jeonwonje/beachboys/docs/figures/fig17-b40-rates.png

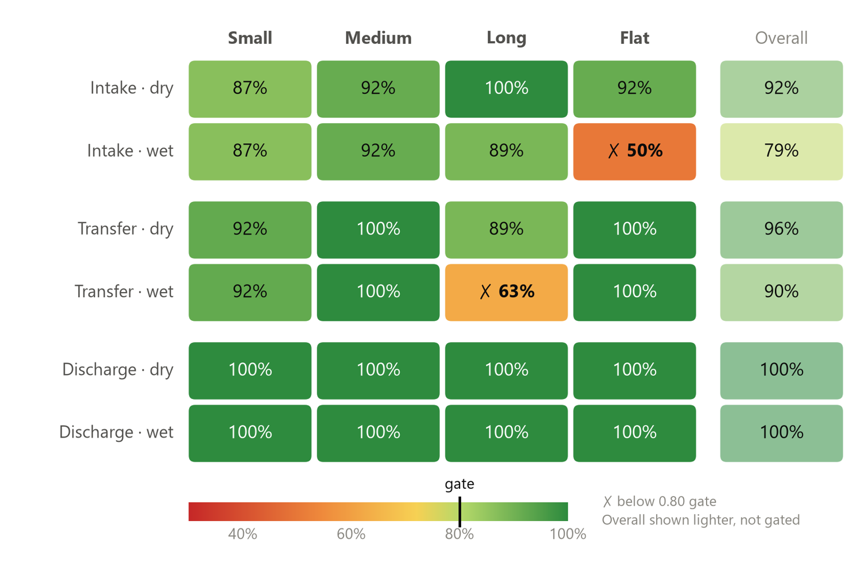
docs/figures/fig17-b40-rates.png
