jeonwonje/beachboys/docs/figures/fig25-settling.jpg

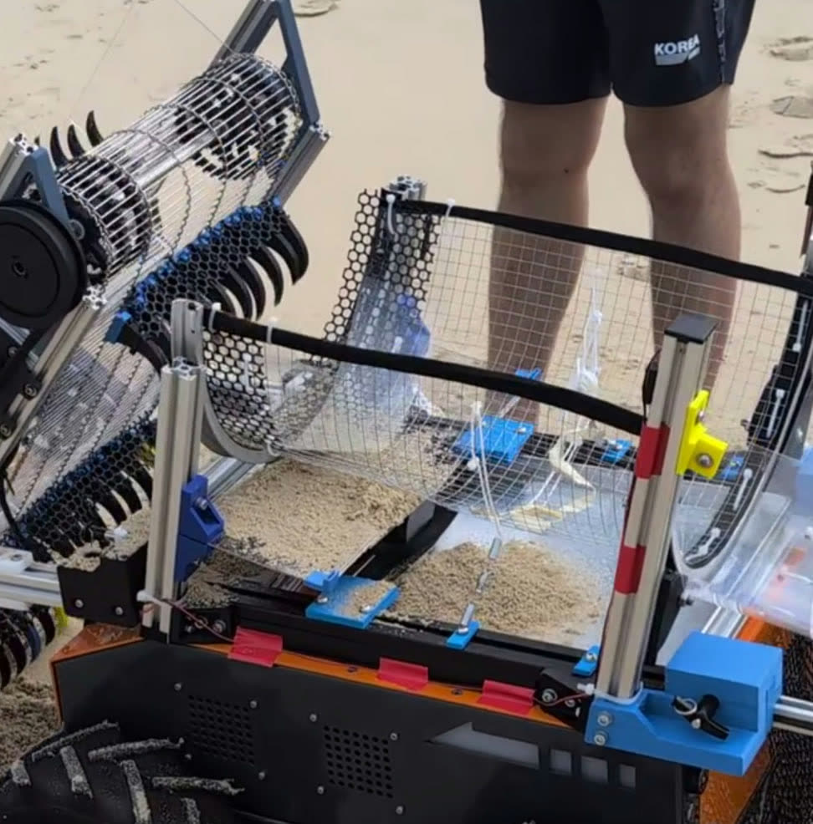
docs/figures/fig25-settling.jpg
