jeonwonje/beachboys/hardware/module/ASI-301_integrated_assembly.step

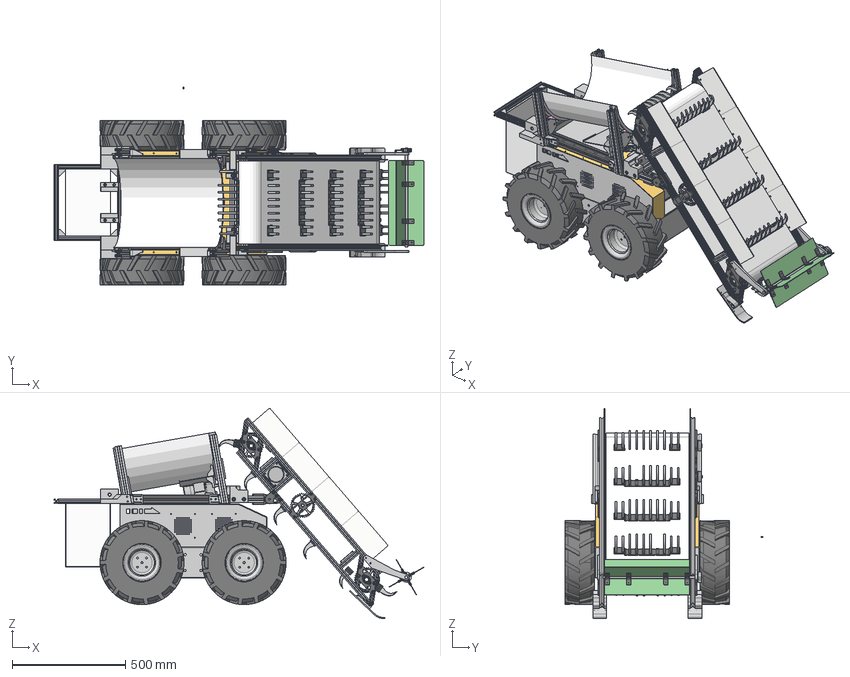
[picture p9: CAD file, 2026-11-07]
hardware/module/ASI-301_integrated_assembly.step
1630.1 x 873.8 x 925.6 mm
sheet metal cover
upper compartment
bottom compartment
shaft bearing
wheel hub
wheel axle
wheel
shaft bearing v1(Mirror)
wheel hub v1(Mirror)
wheel axle v1(Mirror)
wheel v1(Mirror)
shaft bearing v1(Mirror) (1)
wheel hub v1(Mirror) (1)
wheel axle v1(Mirror) (1)
wheel v1(Mirror) (1)
shaft bearing v1(Mirror)(Mirror)
wheel hub v1(Mirror)(Mirror)
wheel axle v1(Mirror)(Mirror)
wheel v1(Mirror)(Mirror)
2020 Extrusion 336mm x 2
2020 bracket x 4
collection bin mesh
2020 Extrusion 260mm x 2
sand collection plate
back pin mount on bin x 2
back pin mount on 4040
back pin mount on 4040 v17(Mirror)
2020 Frame long x 2
2020 Frame wide x 4
2020 Motor mount x 3
2020 Frame horizontal support x 2
2020 90° plate x 2
2020 90° connector x 4
Skid
Skid inner mount
Skid outer mount
20x23x21.5mm GFM Plain bearing
P30S5M0100AAL-NA-P-20_p
SET-SCREW6-8
SET-SCREW6-8_1
20mm OD Drive axle
9.2mm Pitch sproket (2)
9.2mm Pitch sproket (1)
9.2mm Pitch sproket (2)_1
9.2mm Pitch sproket (1)_1
20mm OD Idler axle
20x23x21.5mm GFM Plain bearing_1
Bearing retainer
P30S5M0100AAL-NA-N-10_p
SET-SCREW4-3
SET-SCREW4-3_1
GPG24V 40W 80mm Motor
Drive shaft mount
Motor mount
Drive shaft mount_1
Conveyor square panel x 4
middle support bearing
12.7x100mm OD unit axle v1
9.2mm Pitch sproket (2)_2
9.2mm Pitch sproket (1)_2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
