jeonwonje/beachboys/hardware/electronics-case/Case_v3_Wall_Front.SLDPRT

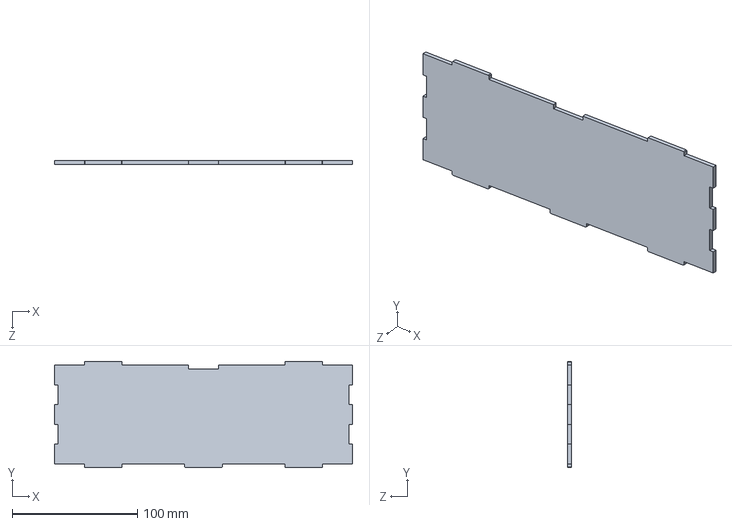
[picture p10: CAD file, 2026-11-06]
hardware/electronics-case/Case_v3_Wall_Front.SLDPRT
237.8 x 84.8 x 2.90 mm
