jeonwonje/beachboys/hardware/electronics-case/ASI301_case_acrylic_3mm_nest_revB.dxf

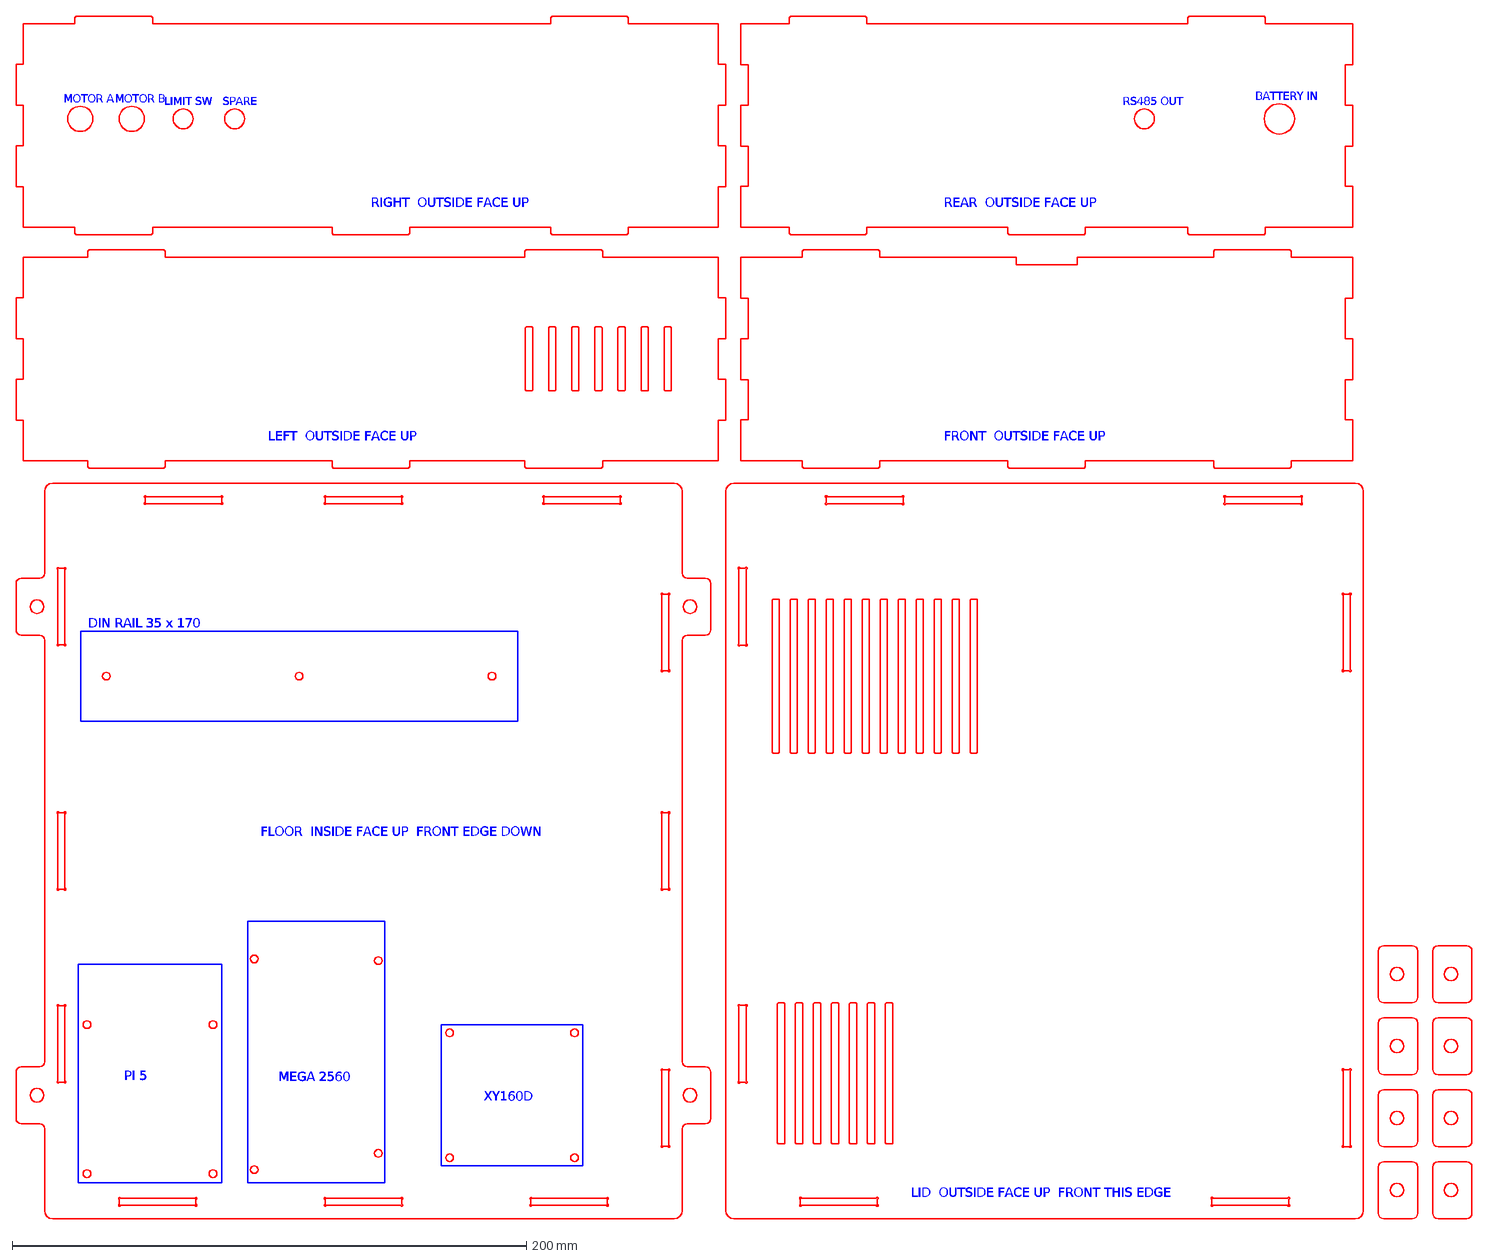
[picture p11: CAD file, 2026-11-06]
hardware/electronics-case/ASI301_case_acrylic_3mm_nest_revB.dxf
PI 5
MEGA 2560
XY160D
DIN RAIL 35 x 170
FLOOR INSIDE FACE UP FRONT EDGE DOWN
LID OUTSIDE FACE UP FRONT THIS EDGE
LEFT OUTSIDE FACE UP
FRONT OUTSIDE FACE UP
MOTOR A
MOTOR B
LIMIT SW
SPARE
RIGHT OUTSIDE FACE UP
BATTERY IN
RS485 OUT
REAR OUTSIDE FACE UP
