jeonwonje/beachboys/hardware/electronics-case/Case_v3_Floor.SLDPRT

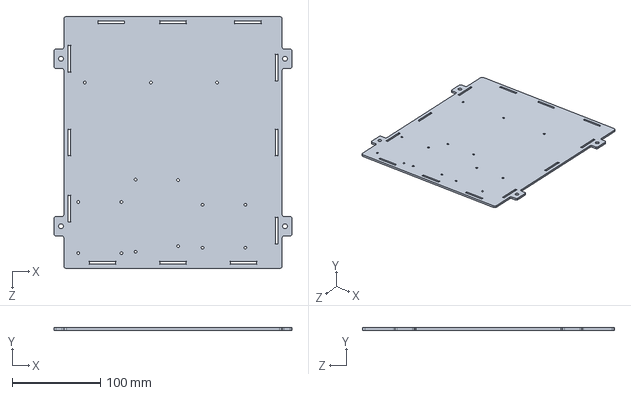
[picture p12: CAD file, 2026-11-06]
hardware/electronics-case/Case_v3_Floor.SLDPRT
270.0 x 2.90 x 285.8 mm
