jeonwonje/beachboys/hardware/electronics-case/Case_v3_Wall_Left.SLDPRT

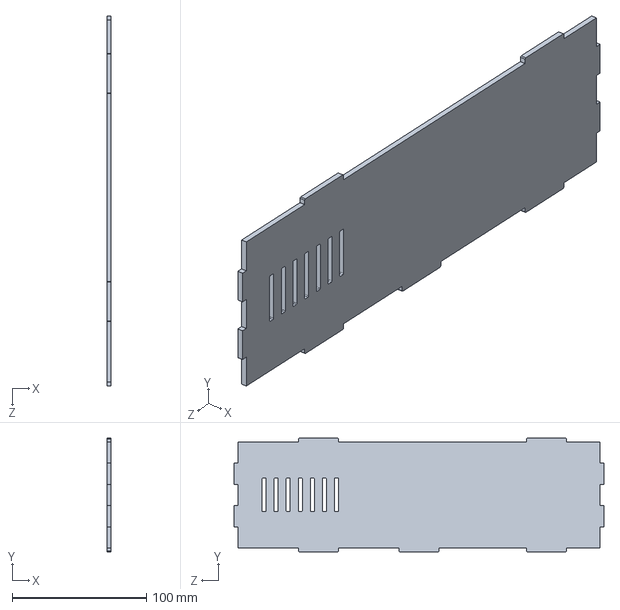
[picture p13: CAD file, 2026-11-06]
hardware/electronics-case/Case_v3_Wall_Left.SLDPRT
2.90 x 84.8 x 275.8 mm
