jeonwonje/beachboys/hardware/electronics-case/M3 brass standoff Mega post.SLDPRT

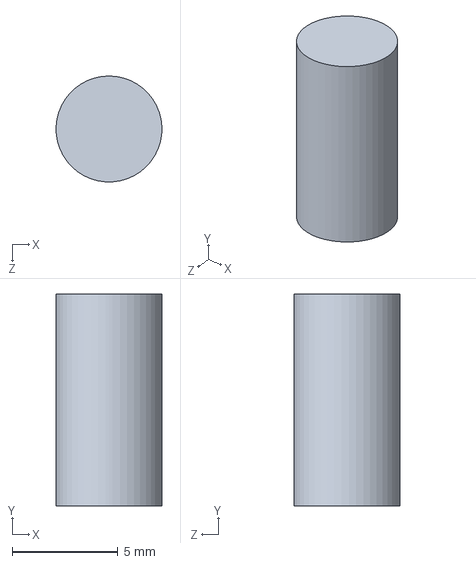
[picture p14: CAD file, 2026-11-06]
hardware/electronics-case/M3 brass standoff Mega post.SLDPRT
5.00 x 10.0 x 5.00 mm
