jeonwonje/beachboys/hardware/electronics-case/ASI301_fit_coupon_3mm.dxf

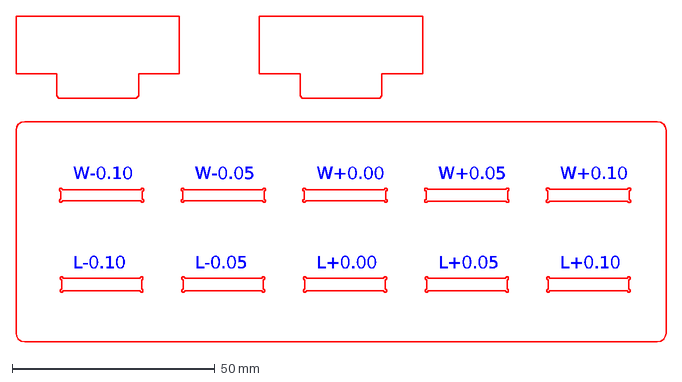
[picture p15: CAD file, 2026-11-06]
hardware/electronics-case/ASI301_fit_coupon_3mm.dxf
W-0.10
L-0.10
W-0.05
L-0.05
W+0.00
L+0.00
W+0.05
L+0.05
W+0.10
L+0.10
