jeonwonje/beachboys/hardware/electronics-case/Case_v3_Pads.SLDPRT

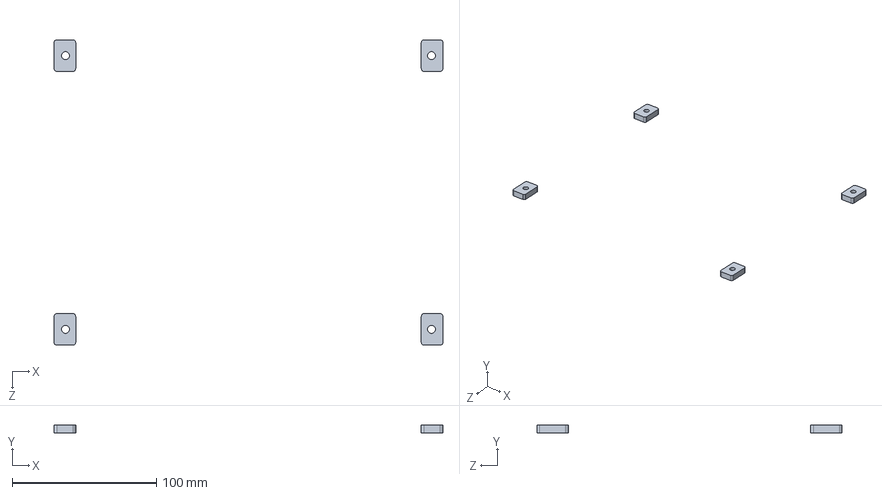
[picture p16: CAD file, 2026-11-06]
hardware/electronics-case/Case_v3_Pads.SLDPRT
270.0 x 5.80 x 212.0 mm
