jeonwonje/beachboys/hardware/electronics-case/Case_v3_Lid.SLDPRT

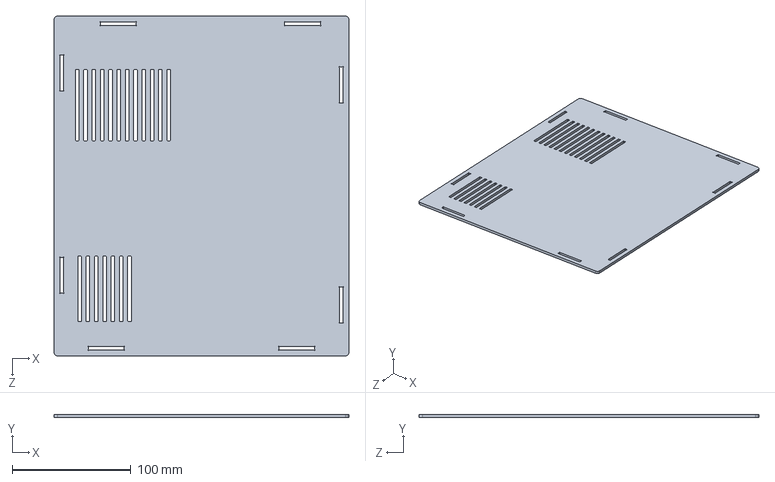
[picture p17: CAD file, 2026-11-06]
hardware/electronics-case/Case_v3_Lid.SLDPRT
247.8 x 2.90 x 285.8 mm
