jeonwonje/beachboys/hardware/electronics-case/ASI-301 Electronics Case v3.step

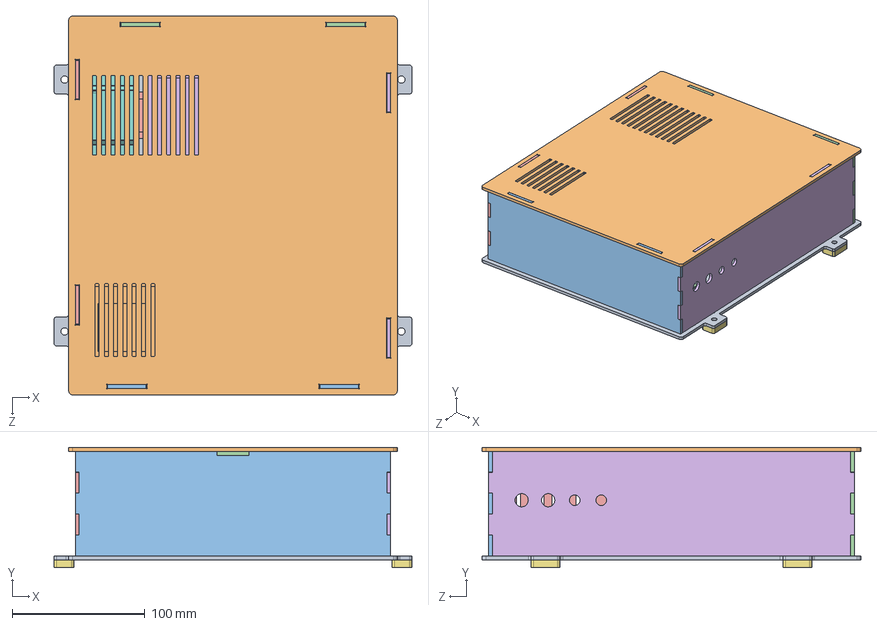
[picture p18: CAD file, 2026-11-06]
hardware/electronics-case/ASI-301 Electronics Case v3.step
270.0 x 90.6 x 285.8 mm
Case_v3_Floor
Case_v3_Lid
Case_v3_Wall_Front
Case_v3_Wall_Rear
Case_v3_Wall_Left
Case_v3_Wall_Right
Case_v3_Pads
M3 brass standoff Mega post
M3 brass standoffs x11
Raspberry Pi 5 (block)
Arduino Mega 2560
XY160D motor driver
DIN rail 35x7.5 170mm
Waveshare USB TO 2CH RS485
Relay module 5V 30A DIN
DDR-30G-5
