jeonwonje/beachboys/(list of files, cad)

Other CAD files:
hardware/electronics-case/Case_v3_Wall_Right.SLDPRT
hardware/electronics-case/Case_v3_Wall_Rear.SLDPRT
hardware/electronics-case/ASI-301 Electronics Case v3.SLDASM
