jeonwonje/beachboys/hardware/electrical/XY160D_Mega2560_wiring.png

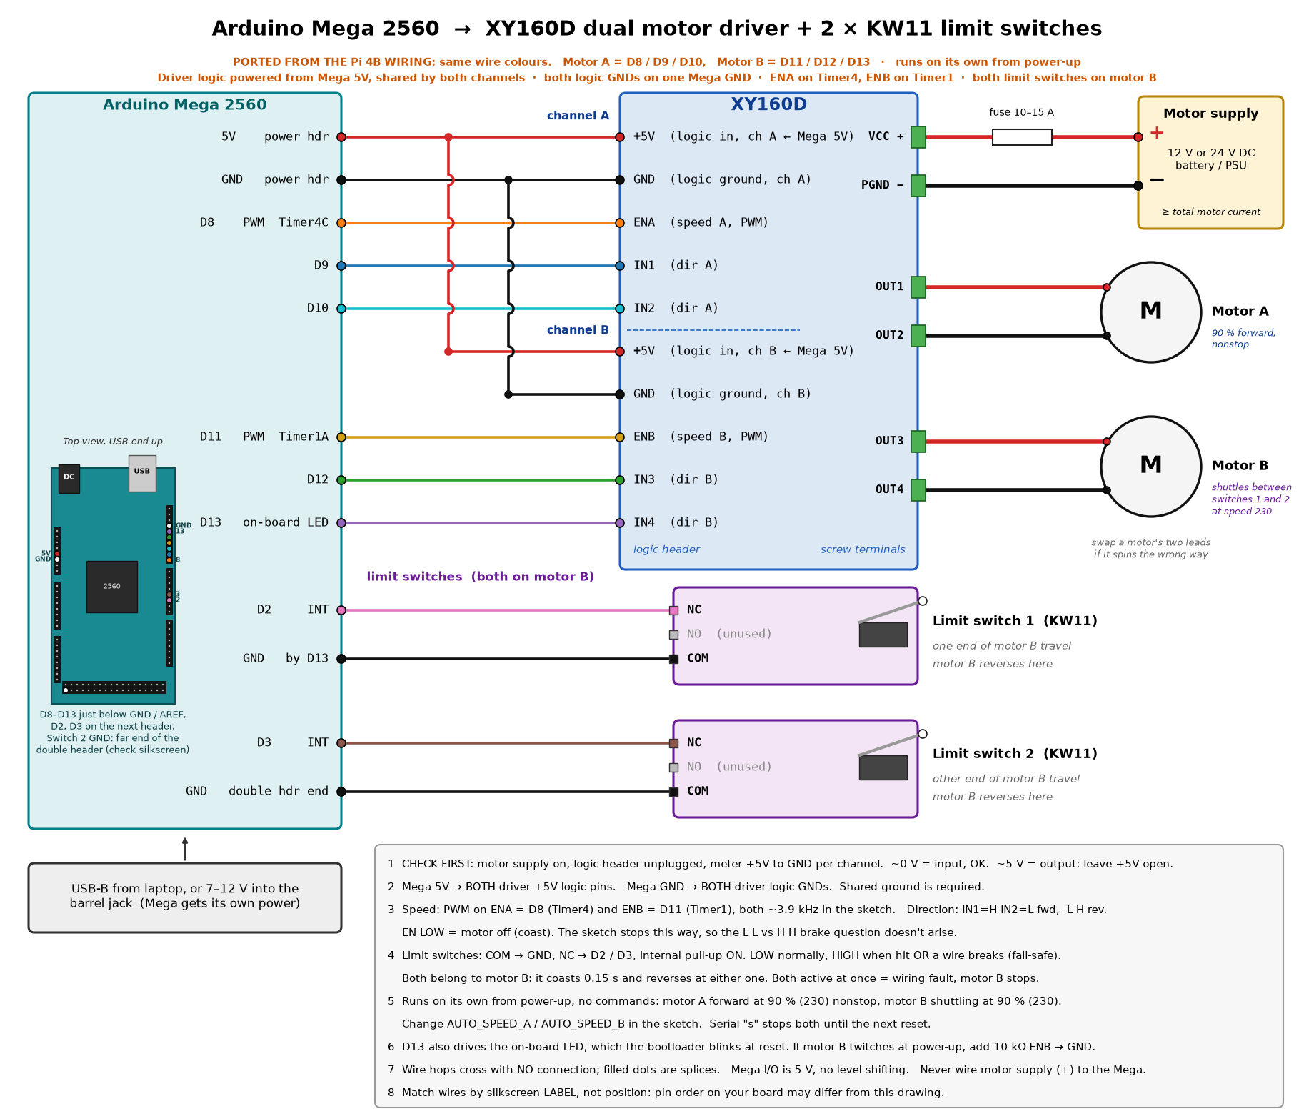
hardware/electrical/XY160D_Mega2560_wiring.png
