jeonwonje/beachboys/hardware/electronics-case/ASI301_case_acrylic_3mm_revB.pdf

## LID

## REAR

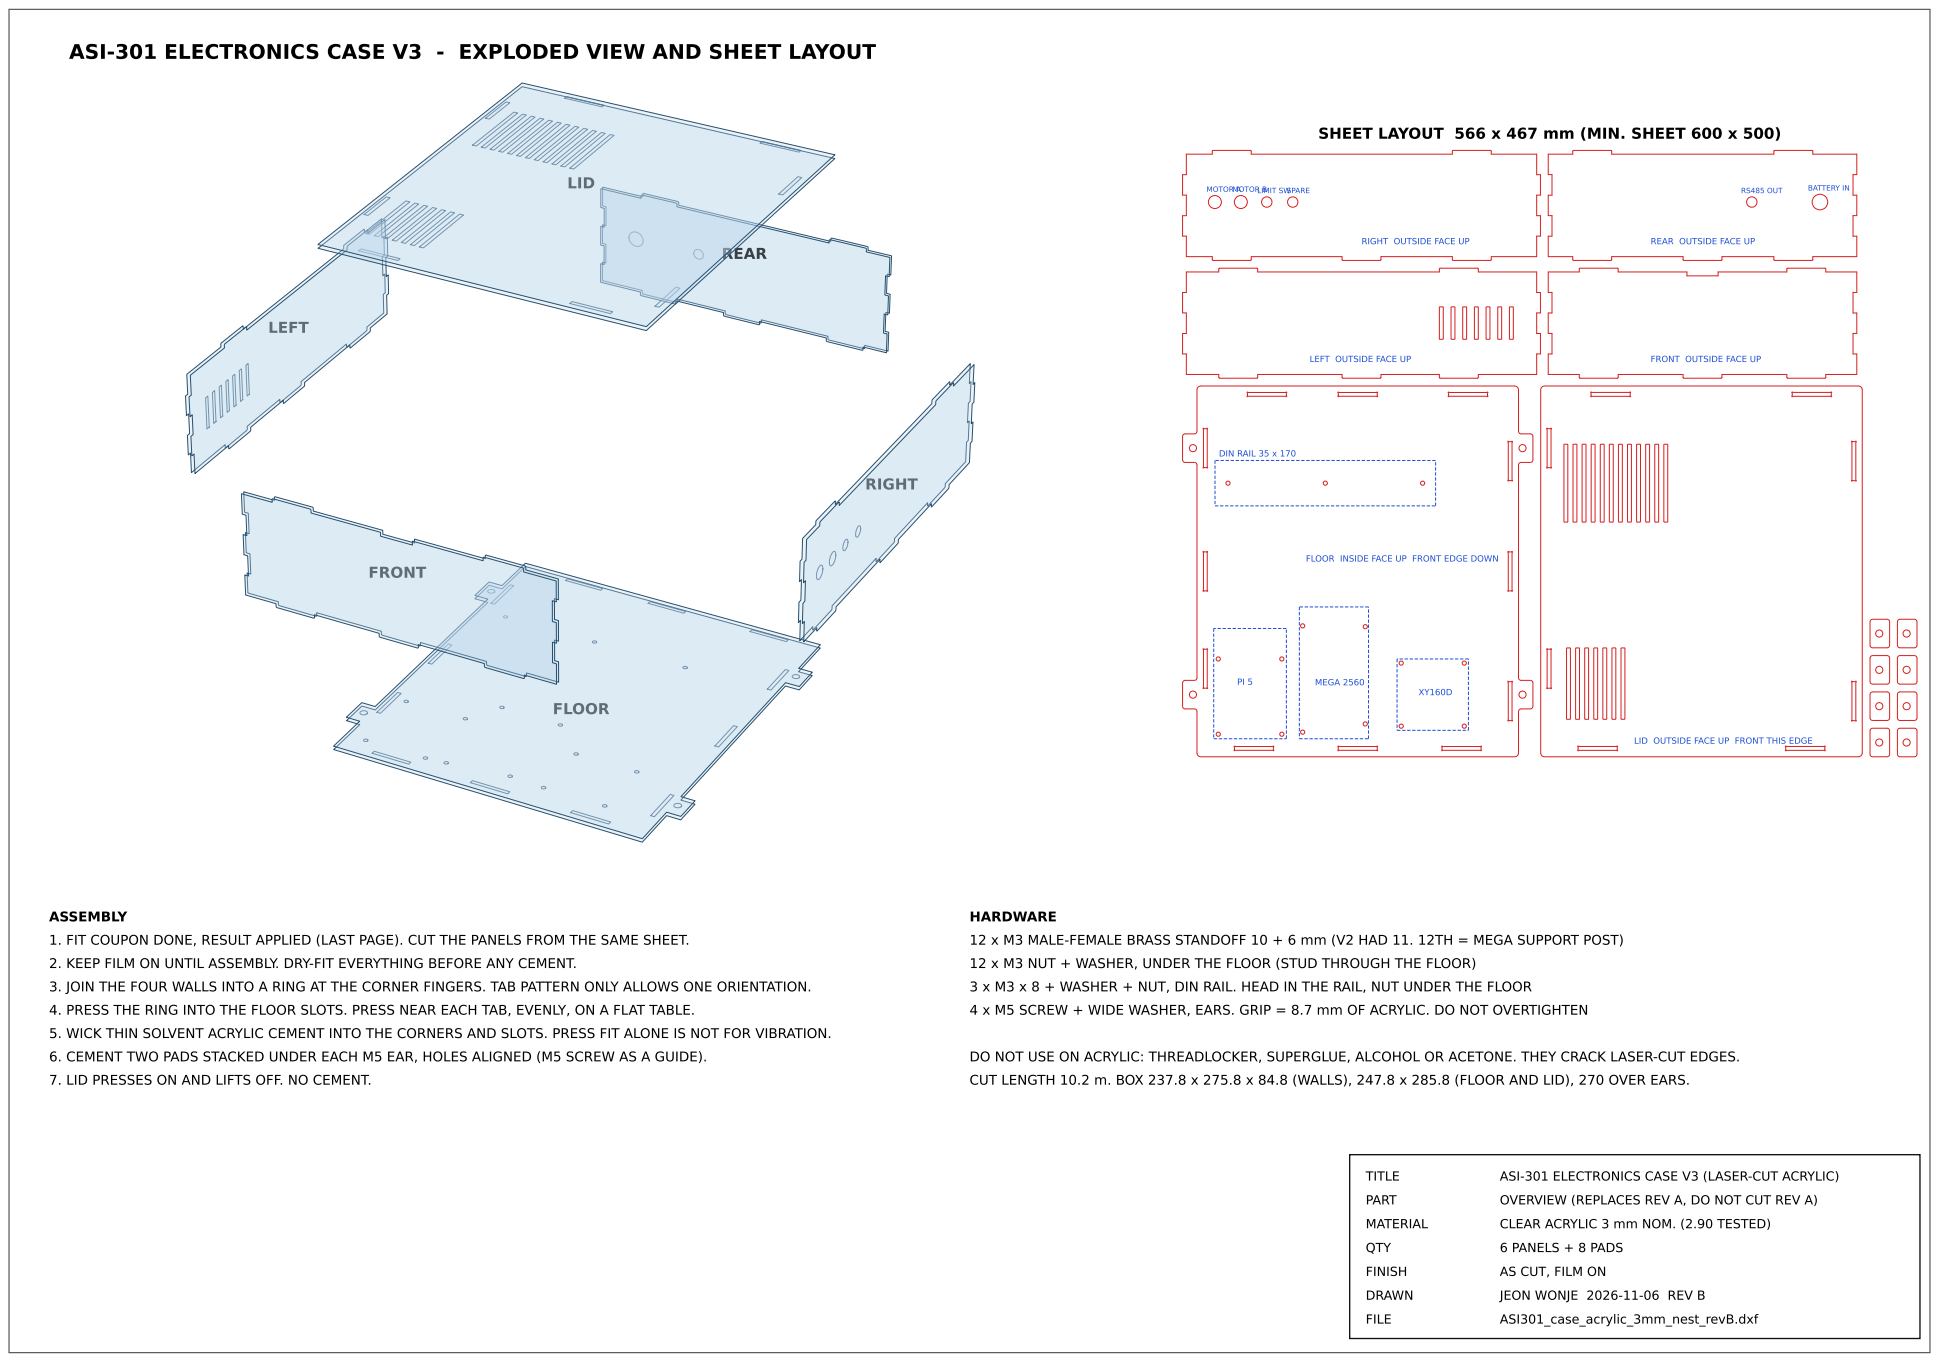
[picture p22: page 1]
FLOOR; FRONT; LEFT; RIGHT; MEGA 2560; DIN RAIL 35 x 170; LEFT OUTSIDE FACE UP; FRONT OUTSIDE FACE UP; RS485 OUT; BATTERY IN; TITLE; ASI-301 ELECTRONICS CASE V3 (LASER-CUT ACRYLIC); PART; OVERVIEW (REPLACES REV A, DO NOT CUT REV A); MATERIAL; CLEAR ACRYLIC 3 mm NOM. (2.90 TESTED); QTY; 6 PANELS + 8 PADS; FINISH; AS CUT, FILM ON; DRAWN; JEON WONJE 2026-11-06 REV B; FILE; ASI301_case_acrylic_3mm_nest_revB.dxf

ASI-301 ELECTRONICS CASE V3 - EXPLODED VIEW AND SHEET LAYOUT

SHEET LAYOUT 566 x 467 mm (MIN. SHEET 600 x 500)

MOTOR AMOTOR BLIMIT SWSPARE

RIGHT OUTSIDE FACE UP

REAR OUTSIDE FACE UP

FLOOR INSIDE FACE UP FRONT EDGE DOWN

LID OUTSIDE FACE UP FRONT THIS EDGE

ASSEMBLY
1. FIT COUPON DONE, RESULT APPLIED (LAST PAGE). CUT THE PANELS FROM THE SAME SHEET.
2. KEEP FILM ON UNTIL ASSEMBLY. DRY-FIT EVERYTHING BEFORE ANY CEMENT.
3. JOIN THE FOUR WALLS INTO A RING AT THE CORNER FINGERS. TAB PATTERN ONLY ALLOWS ONE ORIENTATION.
4. PRESS THE RING INTO THE FLOOR SLOTS. PRESS NEAR EACH TAB, EVENLY, ON A FLAT TABLE.
5. WICK THIN SOLVENT ACRYLIC CEMENT INTO THE CORNERS AND SLOTS. PRESS FIT ALONE IS NOT FOR VIBRATION.
6. CEMENT TWO PADS STACKED UNDER EACH M5 EAR, HOLES ALIGNED (M5 SCREW AS A GUIDE).
7. LID PRESSES ON AND LIFTS OFF. NO CEMENT.

HARDWARE
12 x M3 MALE-FEMALE BRASS STANDOFF 10 + 6 mm (V2 HAD 11. 12TH = MEGA SUPPORT POST)
12 x M3 NUT + WASHER, UNDER THE FLOOR (STUD THROUGH THE FLOOR)
3 x M3 x 8 + WASHER + NUT, DIN RAIL. HEAD IN THE RAIL, NUT UNDER THE FLOOR
4 x M5 SCREW + WIDE WASHER, EARS. GRIP = 8.7 mm OF ACRYLIC. DO NOT OVERTIGHTEN

DO NOT USE ON ACRYLIC: THREADLOCKER, SUPERGLUE, ALCOHOL OR ACETONE. THEY CRACK LASER-CUT EDGES.
CUT LENGTH 10.2 m. BOX 237.8 x 275.8 x 84.8 (WALLS), 247.8 x 285.8 (FLOOR AND LID), 270 OVER EARS.

FLOOR (INSIDE FACE UP) - NTS - DATUM 0,0 BOTTOM-LEFT | TAG | X | Y SIZE | FEATURE

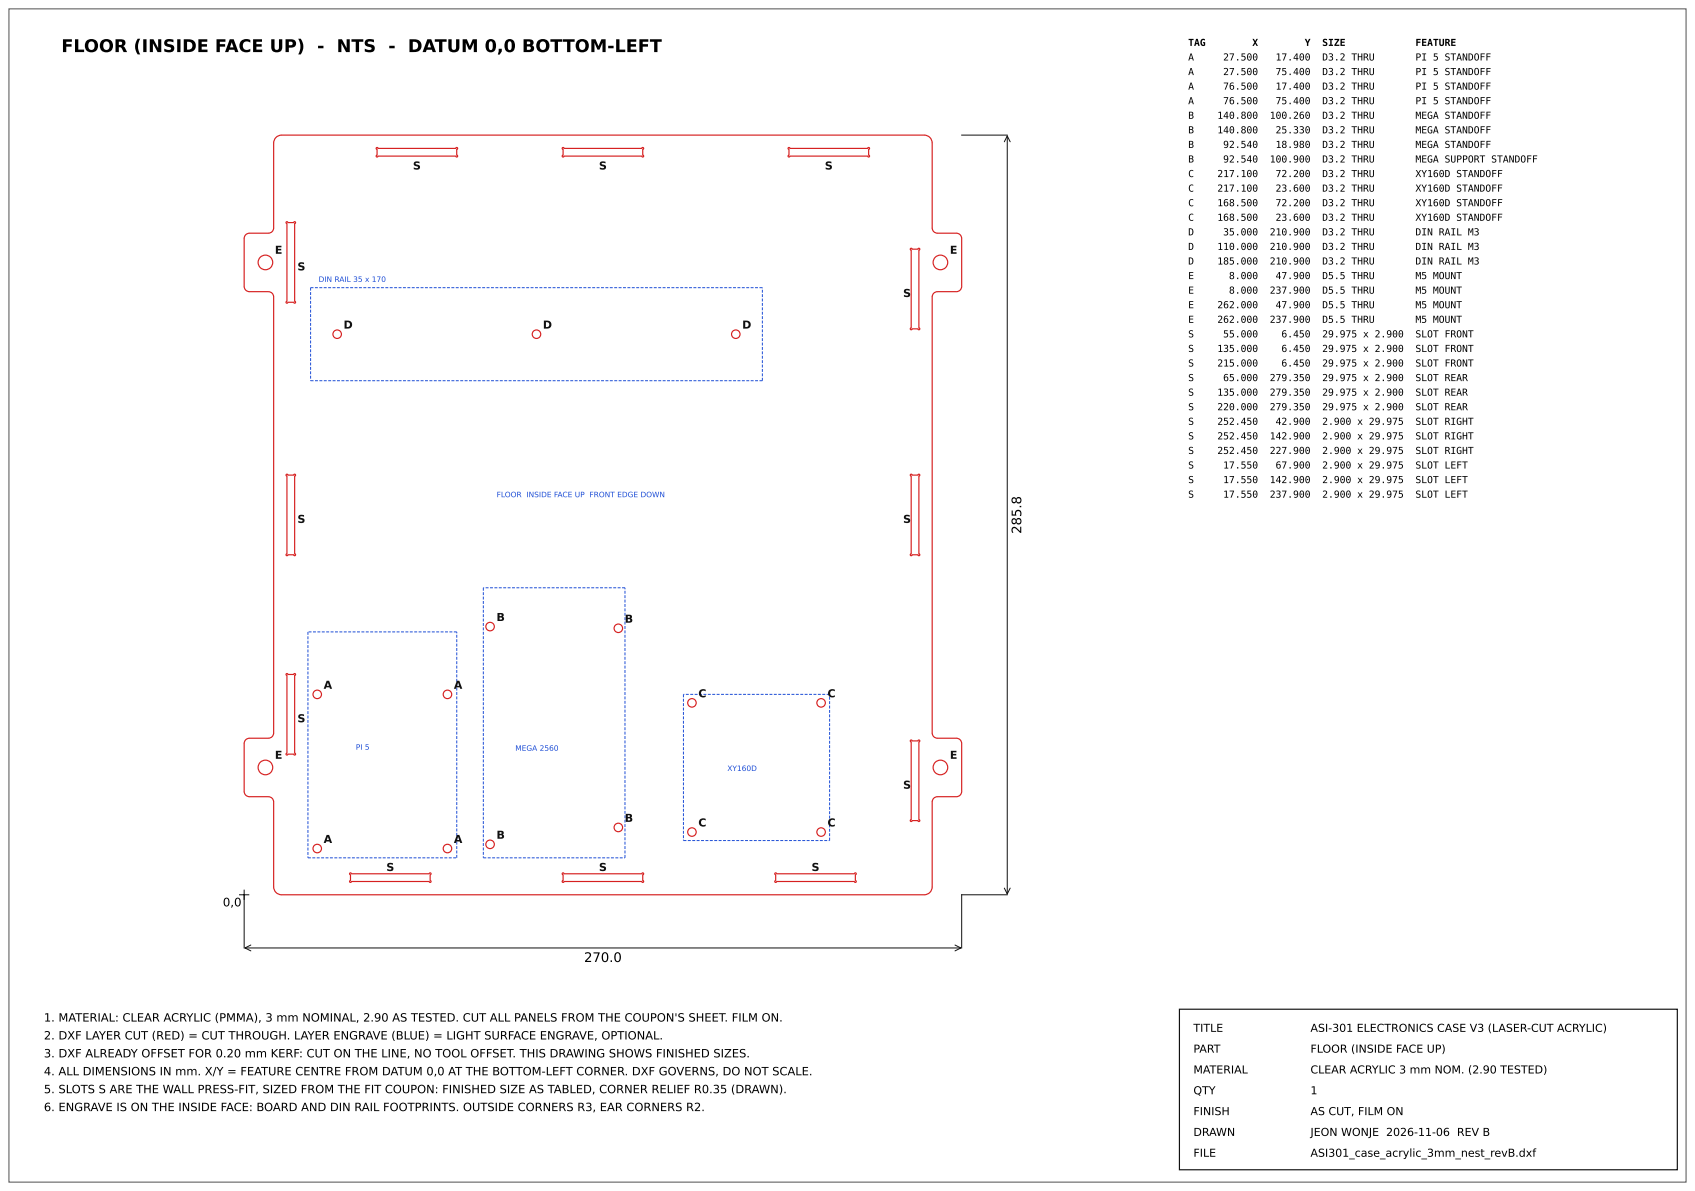
[picture p23: page 2]
MEGA 2560; DIN RAIL 35 x 170; 17.400 D3.2 THRU; PI 5 STANDOFF; 75.400 D3.2 THRU; 140.800 100.260 D3.2 THRU; MEGA STANDOFF; 25.330 D3.2 THRU; 18.980 D3.2 THRU; 92.540 100.900 D3.2 THRU; MEGA SUPPORT STANDOFF; 72.200 D3.2 THRU; XY160D STANDOFF; 23.600 D3.2 THRU; 35.000 210.900 D3.2 THRU; DIN RAIL M3; 110.000 210.900 D3.2 THRU; 185.000 210.900 D3.2 THRU; 47.900 D5.5 THRU; M5 MOUNT; 8.000 237.900 D5.5 THRU; 262.000 237.900 D5.5 THRU; 6.450 29.975 x 2.900 SLOT FRONT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

FLOOR INSIDE FACE UP FRONT EDGE DOWN

1. MATERIAL: CLEAR ACRYLIC (PMMA), 3 mm NOMINAL, 2.90 AS TESTED. CUT ALL PANELS FROM THE COUPON'S SHEET. FILM ON.
2. DXF LAYER CUT (RED) = CUT THROUGH. LAYER ENGRAVE (BLUE) = LIGHT SURFACE ENGRAVE, OPTIONAL.
3. DXF ALREADY OFFSET FOR 0.20 mm KERF: CUT ON THE LINE, NO TOOL OFFSET. THIS DRAWING SHOWS FINISHED SIZES.
4. ALL DIMENSIONS IN mm. X/Y = FEATURE CENTRE FROM DATUM 0,0 AT THE BOTTOM-LEFT CORNER. DXF GOVERNS, DO NOT SCALE.
5. SLOTS S ARE THE WALL PRESS-FIT, SIZED FROM THE FIT COUPON: FINISHED SIZE AS TABLED, CORNER RELIEF R0.35 (DRAWN).
6. ENGRAVE IS ON THE INSIDE FACE: BOARD AND DIN RAIL FOOTPRINTS. OUTSIDE CORNERS R3, EAR CORNERS R2.

LID (OUTSIDE FACE UP) - NTS - DATUM 0,0 BOTTOM-LEFT | TAG | X | Y SIZE | FEATURE

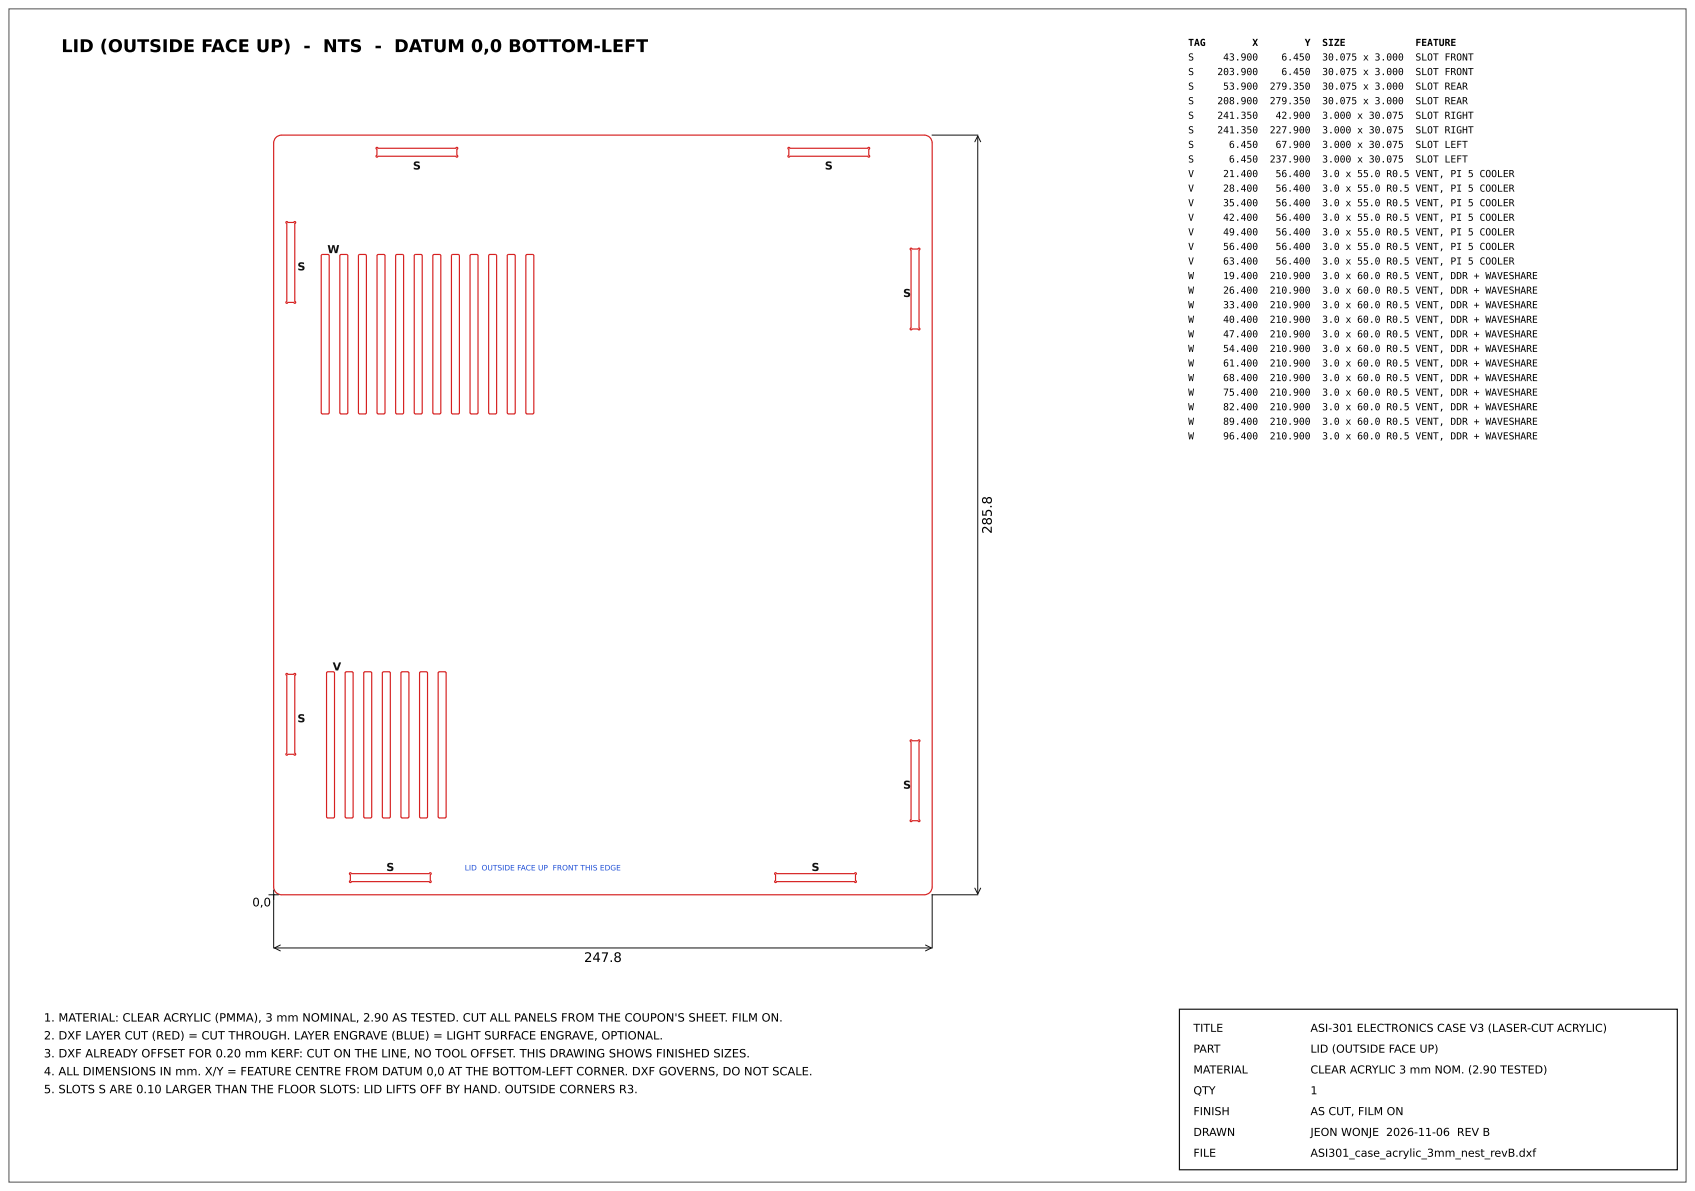
[picture p24: page 3]
6.450 30.075 x 3.000 SLOT FRONT; 53.900 279.350 30.075 x 3.000 SLOT REAR; 208.900 279.350 30.075 x 3.000 SLOT REAR; 42.900 3.000 x 30.075 SLOT RIGHT; 241.350 227.900 3.000 x 30.075 SLOT RIGHT; 67.900 3.000 x 30.075 SLOT LEFT; 6.450 237.900 3.000 x 30.075 SLOT LEFT; 56.400 3.0 x 55.0 R0.5 VENT, PI 5 COOLER; 19.400 210.900 3.0 x 60.0 R0.5 VENT, DDR + WAVESHARE; 26.400 210.900 3.0 x 60.0 R0.5 VENT, DDR + WAVESHARE; 33.400 210.900 3.0 x 60.0 R0.5 VENT, DDR + WAVESHARE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

LID OUTSIDE FACE UP FRONT THIS EDGE

1. MATERIAL: CLEAR ACRYLIC (PMMA), 3 mm NOMINAL, 2.90 AS TESTED. CUT ALL PANELS FROM THE COUPON'S SHEET. FILM ON.
2. DXF LAYER CUT (RED) = CUT THROUGH. LAYER ENGRAVE (BLUE) = LIGHT SURFACE ENGRAVE, OPTIONAL.
3. DXF ALREADY OFFSET FOR 0.20 mm KERF: CUT ON THE LINE, NO TOOL OFFSET. THIS DRAWING SHOWS FINISHED SIZES.
4. ALL DIMENSIONS IN mm. X/Y = FEATURE CENTRE FROM DATUM 0,0 AT THE BOTTOM-LEFT CORNER. DXF GOVERNS, DO NOT SCALE.
5. SLOTS S ARE 0.10 LARGER THAN THE FLOOR SLOTS: LID LIFTS OFF BY HAND. OUTSIDE CORNERS R3.

FRONT WALL (OUTSIDE FACE UP) - NTS - DATUM 0,0 BOTTOM-LEFT | TAG | X | Y SIZE | FEATURE

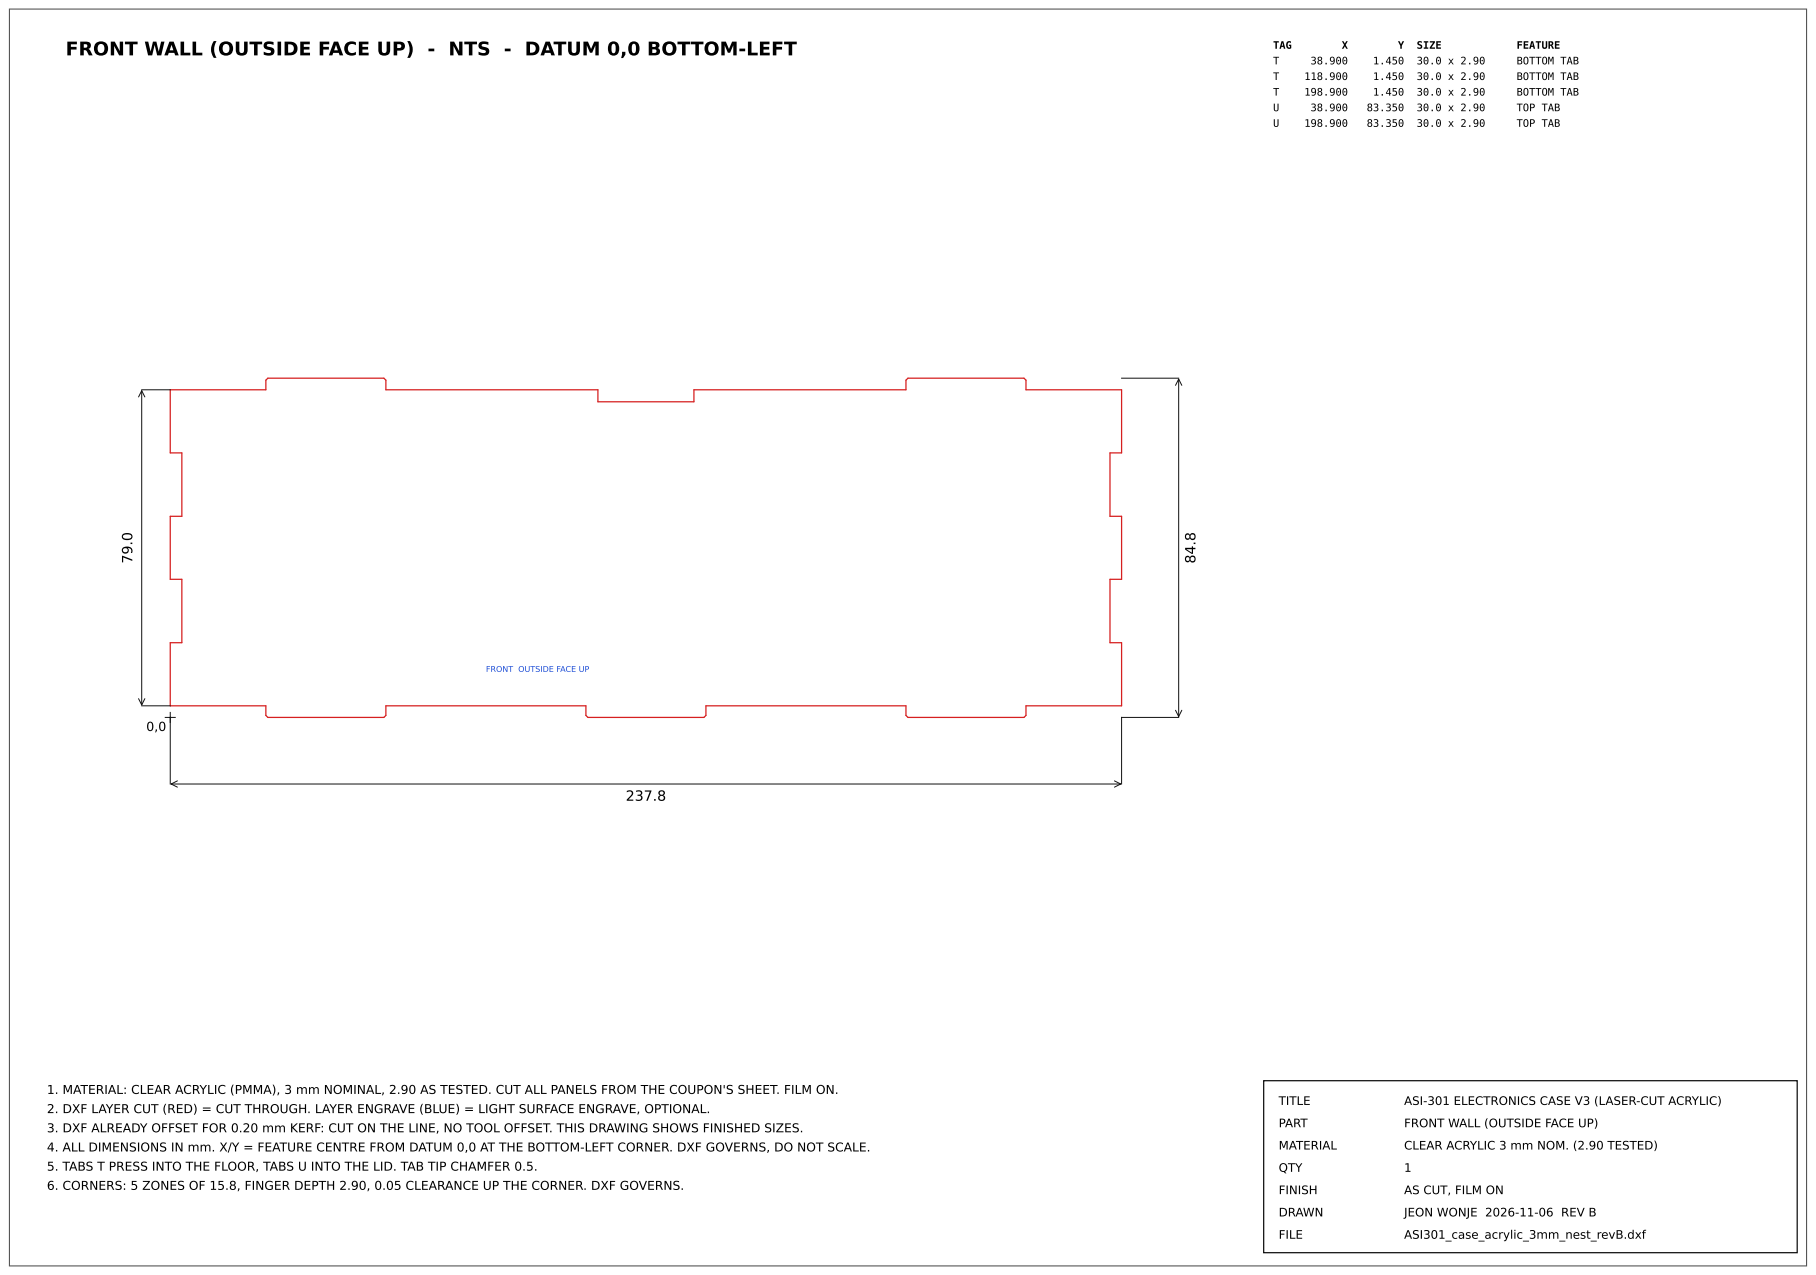
[picture p25: page 4]
BOTTOM TAB; TOP TAB; TITLE; ASI-301 ELECTRONICS CASE V3 (LASER-CUT ACRYLIC); PART; FRONT WALL (OUTSIDE FACE UP); MATERIAL; CLEAR ACRYLIC 3 mm NOM. (2.90 TESTED); QTY

FRONT OUTSIDE FACE UP

1. MATERIAL: CLEAR ACRYLIC (PMMA), 3 mm NOMINAL, 2.90 AS TESTED. CUT ALL PANELS FROM THE COUPON'S SHEET. FILM ON.
2. DXF LAYER CUT (RED) = CUT THROUGH. LAYER ENGRAVE (BLUE) = LIGHT SURFACE ENGRAVE, OPTIONAL.
3. DXF ALREADY OFFSET FOR 0.20 mm KERF: CUT ON THE LINE, NO TOOL OFFSET. THIS DRAWING SHOWS FINISHED SIZES.
4. ALL DIMENSIONS IN mm. X/Y = FEATURE CENTRE FROM DATUM 0,0 AT THE BOTTOM-LEFT CORNER. DXF GOVERNS, DO NOT SCALE.
5. TABS T PRESS INTO THE FLOOR, TABS U INTO THE LID. TAB TIP CHAMFER 0.5.
6. CORNERS: 5 ZONES OF 15.8, FINGER DEPTH 2.90, 0.05 CLEARANCE UP THE CORNER. DXF GOVERNS.

REAR WALL (OUTSIDE FACE UP) - NTS - DATUM 0,0 BOTTOM-LEFT | TAG | X | Y SIZE | FEATURE

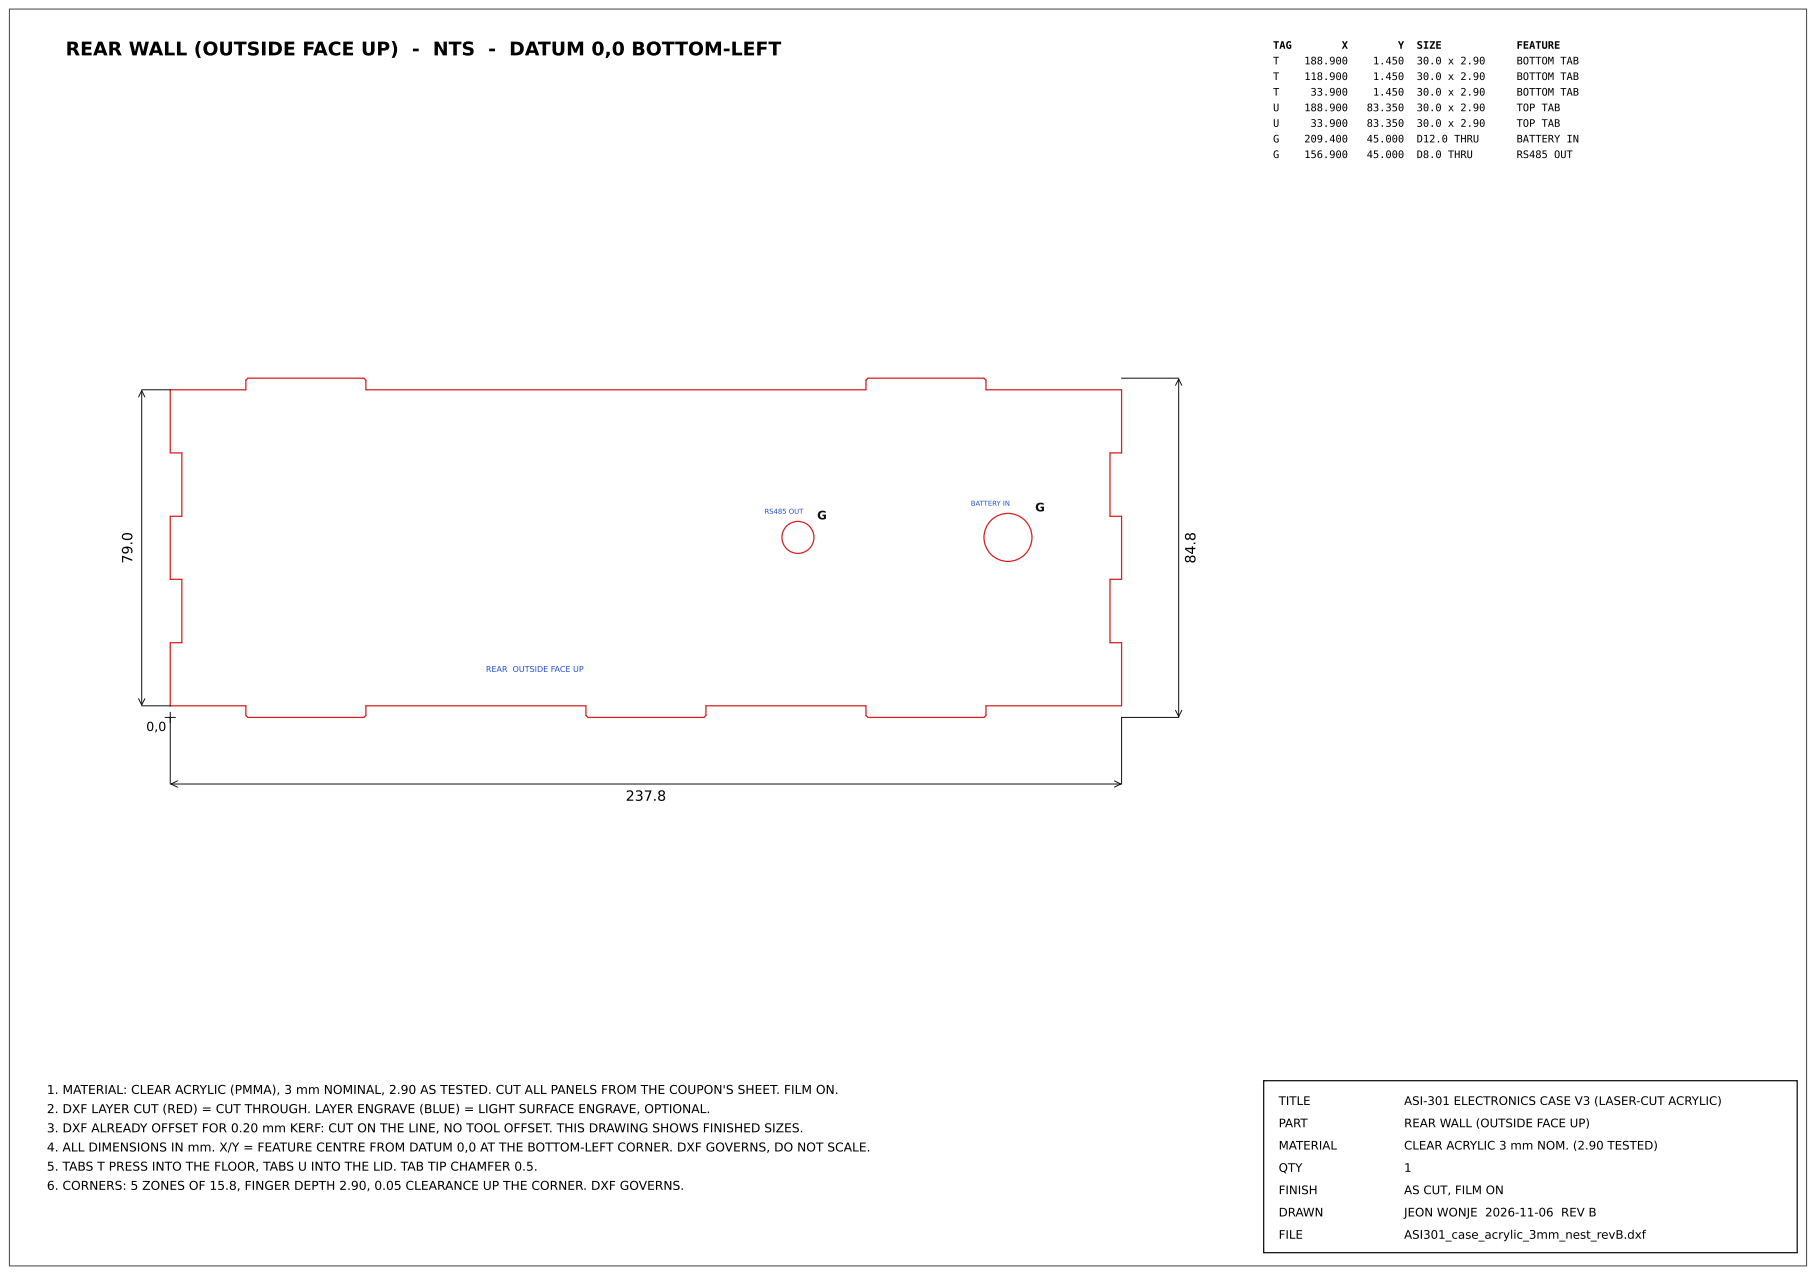
[picture p26: page 5]
BATTERY IN; RS485 OUT; BOTTOM TAB; TOP TAB; 45.000 D12.0 THRU; 45.000 D8.0 THRU; TITLE; ASI-301 ELECTRONICS CASE V3 (LASER-CUT ACRYLIC); PART; REAR WALL (OUTSIDE FACE UP); MATERIAL; CLEAR ACRYLIC 3 mm NOM. (2.90 TESTED); QTY

REAR OUTSIDE FACE UP

1. MATERIAL: CLEAR ACRYLIC (PMMA), 3 mm NOMINAL, 2.90 AS TESTED. CUT ALL PANELS FROM THE COUPON'S SHEET. FILM ON.
2. DXF LAYER CUT (RED) = CUT THROUGH. LAYER ENGRAVE (BLUE) = LIGHT SURFACE ENGRAVE, OPTIONAL.
3. DXF ALREADY OFFSET FOR 0.20 mm KERF: CUT ON THE LINE, NO TOOL OFFSET. THIS DRAWING SHOWS FINISHED SIZES.
4. ALL DIMENSIONS IN mm. X/Y = FEATURE CENTRE FROM DATUM 0,0 AT THE BOTTOM-LEFT CORNER. DXF GOVERNS, DO NOT SCALE.
5. TABS T PRESS INTO THE FLOOR, TABS U INTO THE LID. TAB TIP CHAMFER 0.5.

LEFT WALL (OUTSIDE FACE UP) - NTS - DATUM 0,0 BOTTOM-LEFT | TAG | X | Y SIZE | FEATURE

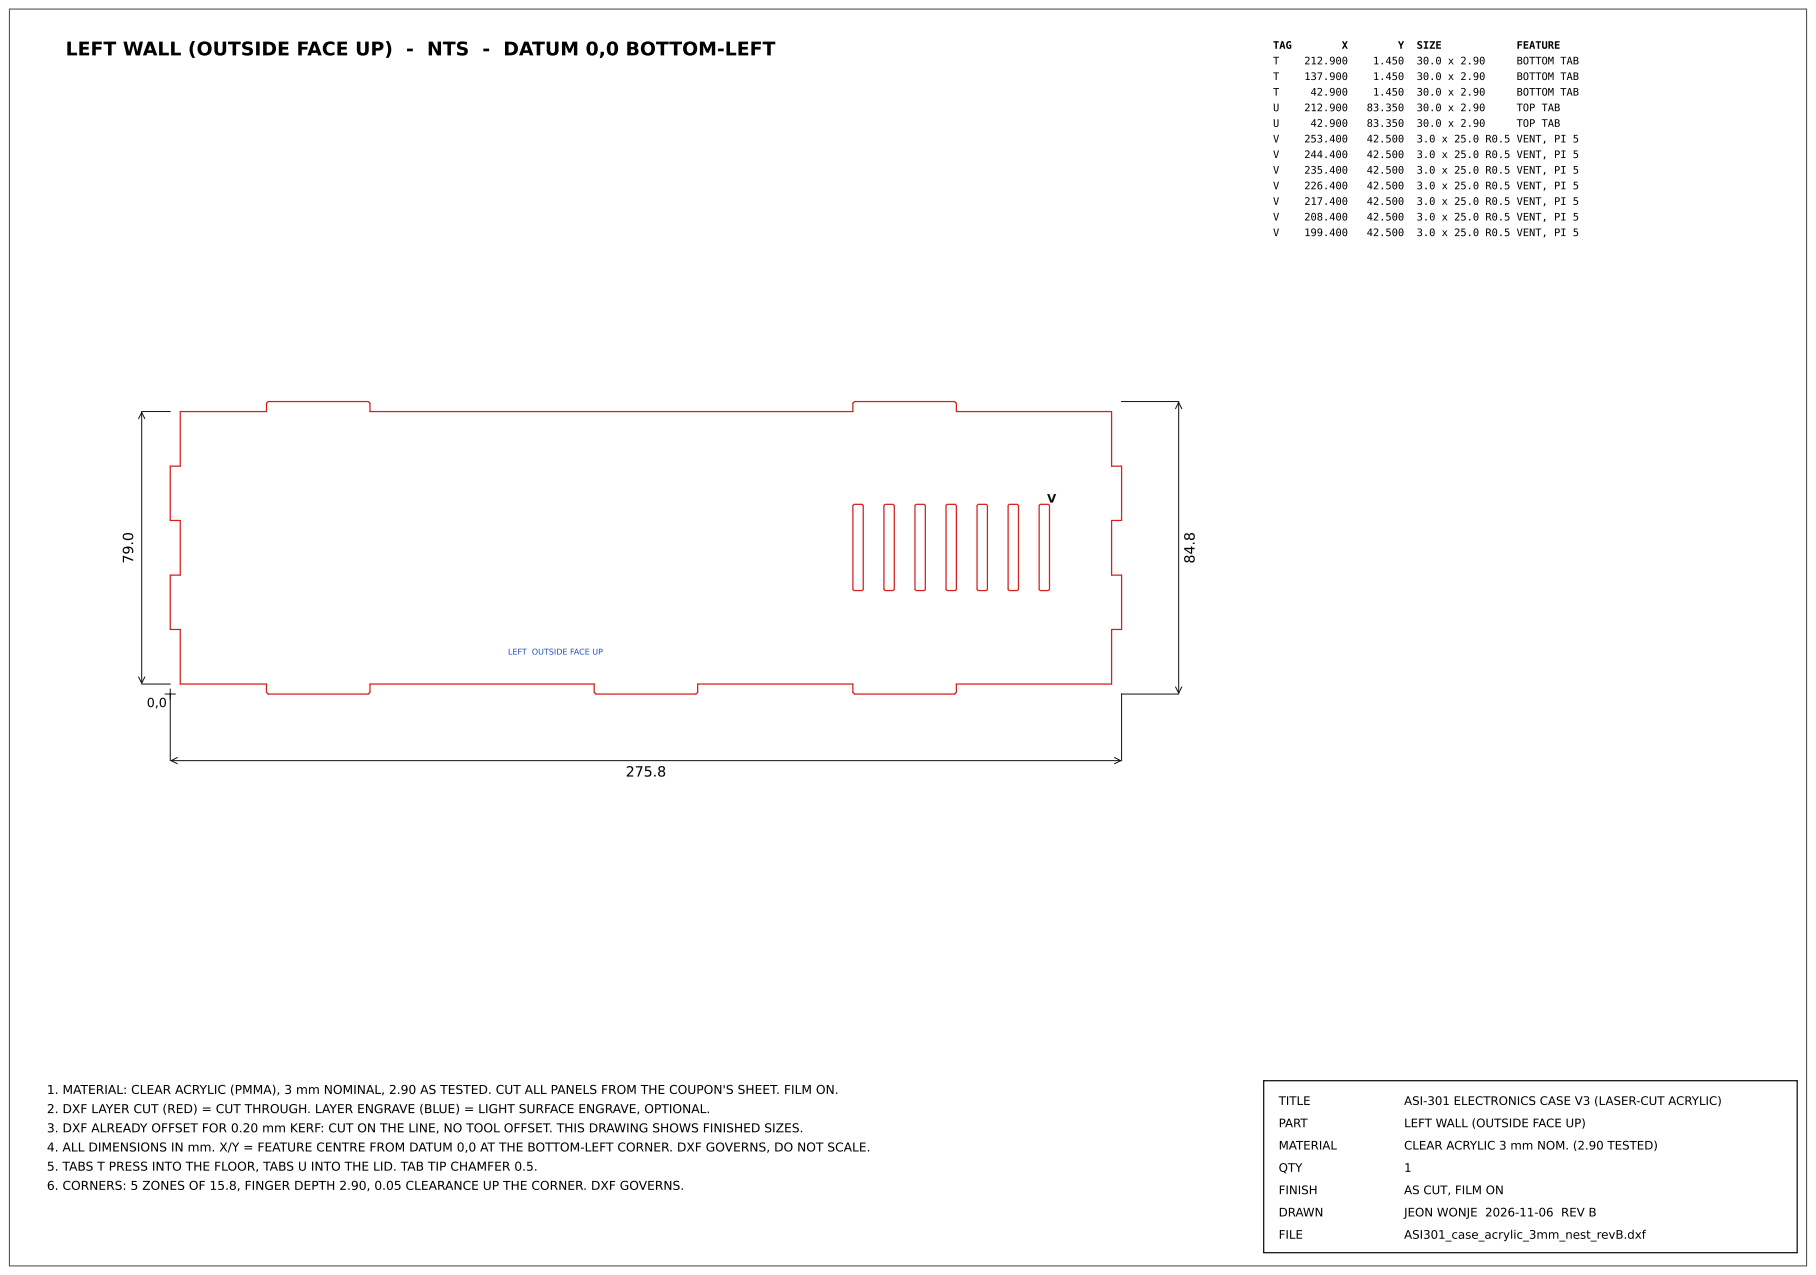
[picture p27: page 6]
BOTTOM TAB; TOP TAB; 42.500 3.0 x 25.0 R0.5 VENT, PI 5; TITLE; ASI-301 ELECTRONICS CASE V3 (LASER-CUT ACRYLIC); PART; LEFT WALL (OUTSIDE FACE UP); MATERIAL; CLEAR ACRYLIC 3 mm NOM. (2.90 TESTED); QTY

LEFT OUTSIDE FACE UP

1. MATERIAL: CLEAR ACRYLIC (PMMA), 3 mm NOMINAL, 2.90 AS TESTED. CUT ALL PANELS FROM THE COUPON'S SHEET. FILM ON.
2. DXF LAYER CUT (RED) = CUT THROUGH. LAYER ENGRAVE (BLUE) = LIGHT SURFACE ENGRAVE, OPTIONAL.
3. DXF ALREADY OFFSET FOR 0.20 mm KERF: CUT ON THE LINE, NO TOOL OFFSET. THIS DRAWING SHOWS FINISHED SIZES.
4. ALL DIMENSIONS IN mm. X/Y = FEATURE CENTRE FROM DATUM 0,0 AT THE BOTTOM-LEFT CORNER. DXF GOVERNS, DO NOT SCALE.
5. TABS T PRESS INTO THE FLOOR, TABS U INTO THE LID. TAB TIP CHAMFER 0.5.

RIGHT WALL (OUTSIDE FACE UP) - NTS - DATUM 0,0 BOTTOM-LEFT | TAG | X | Y SIZE | FEATURE
| T | 37.900 | 1.450 30.0 x 2.90 | BOTTOM TAB
| T | 137.900 | 1.450 30.0 x 2.90 | BOTTOM TAB
| T | 222.900 | 1.450 30.0 x 2.90 | BOTTOM TAB
| U | 37.900 | 83.350 30.0 x 2.90 | TOP TAB
| U | 222.900 | 83.350 30.0 x 2.90 | TOP TAB
| G | 24.900 | 45.000 D10.0 THRU | MOTOR A
| G | 44.900 | 45.000 D10.0 THRU | MOTOR B
| G | 64.900 | 45.000 D8.0 THRU | LIMIT SW
| G | 84.900 | 45.000 D8.0 THRU | SPARE

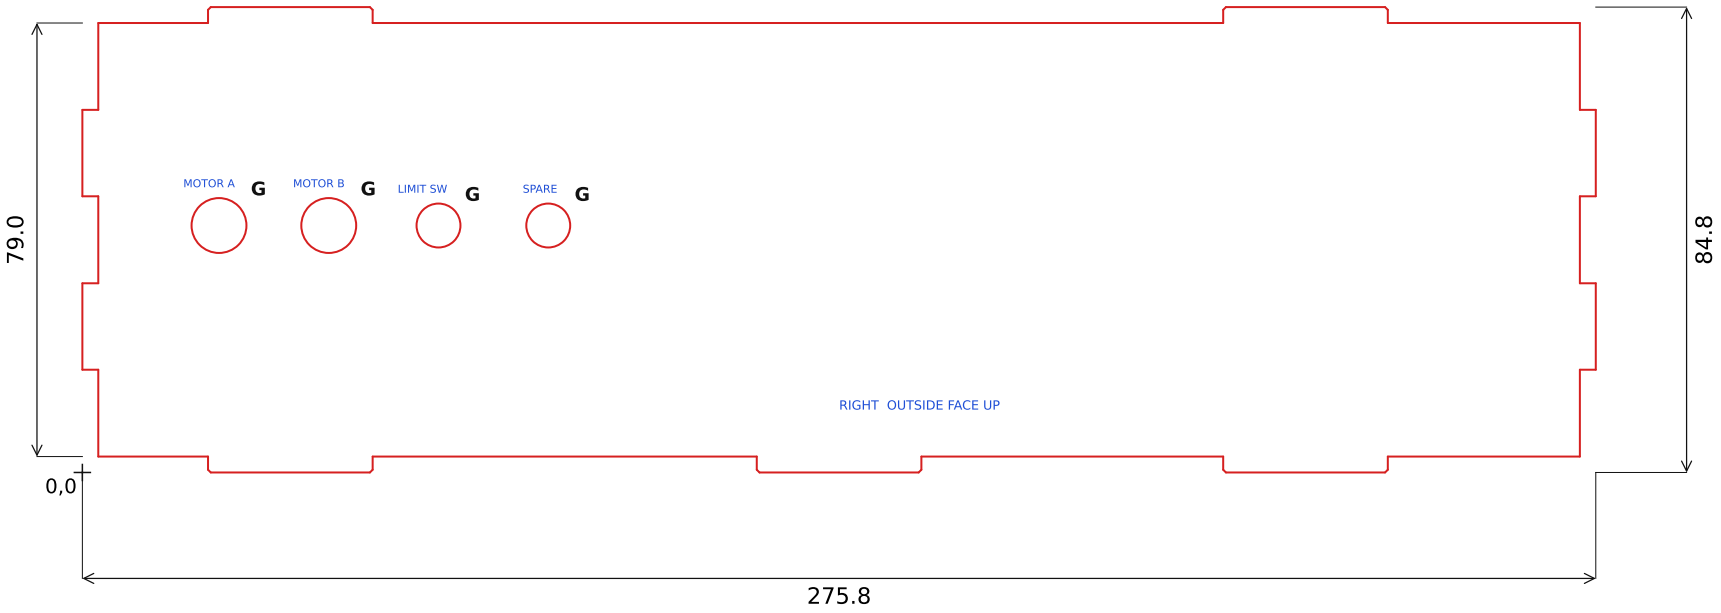
[picture p28: figure]
MOTOR A; MOTOR B; LIMIT SW; SPARE; RIGHT OUTSIDE FACE UP

1. MATERIAL: CLEAR ACRYLIC (PMMA), 3 mm NOMINAL, 2.90 AS TESTED. CUT ALL PANELS FROM THE COUPON'S SHEET. FILM ON.
2. DXF LAYER CUT (RED) = CUT THROUGH. LAYER ENGRAVE (BLUE) = LIGHT SURFACE ENGRAVE, OPTIONAL.
3. DXF ALREADY OFFSET FOR 0.20 mm KERF: CUT ON THE LINE, NO TOOL OFFSET. THIS DRAWING SHOWS FINISHED SIZES.
4. ALL DIMENSIONS IN mm. X/Y = FEATURE CENTRE FROM DATUM 0,0 AT THE BOTTOM-LEFT CORNER. DXF GOVERNS, DO NOT SCALE.
5. TABS T PRESS INTO THE FLOOR, TABS U INTO THE LID. TAB TIP CHAMFER 0.5.
TITLE | ASI-301 ELECTRONICS CASE V3 (LASER-CUT ACRYLIC)
PART | RIGHT WALL (OUTSIDE FACE UP)
MATERIAL | CLEAR ACRYLIC 3 mm NOM. (2.90 TESTED)
QTY | 1

FIT COUPON AND M5 PAD - NTS | COUPON RESULT, 6 NOV 2026

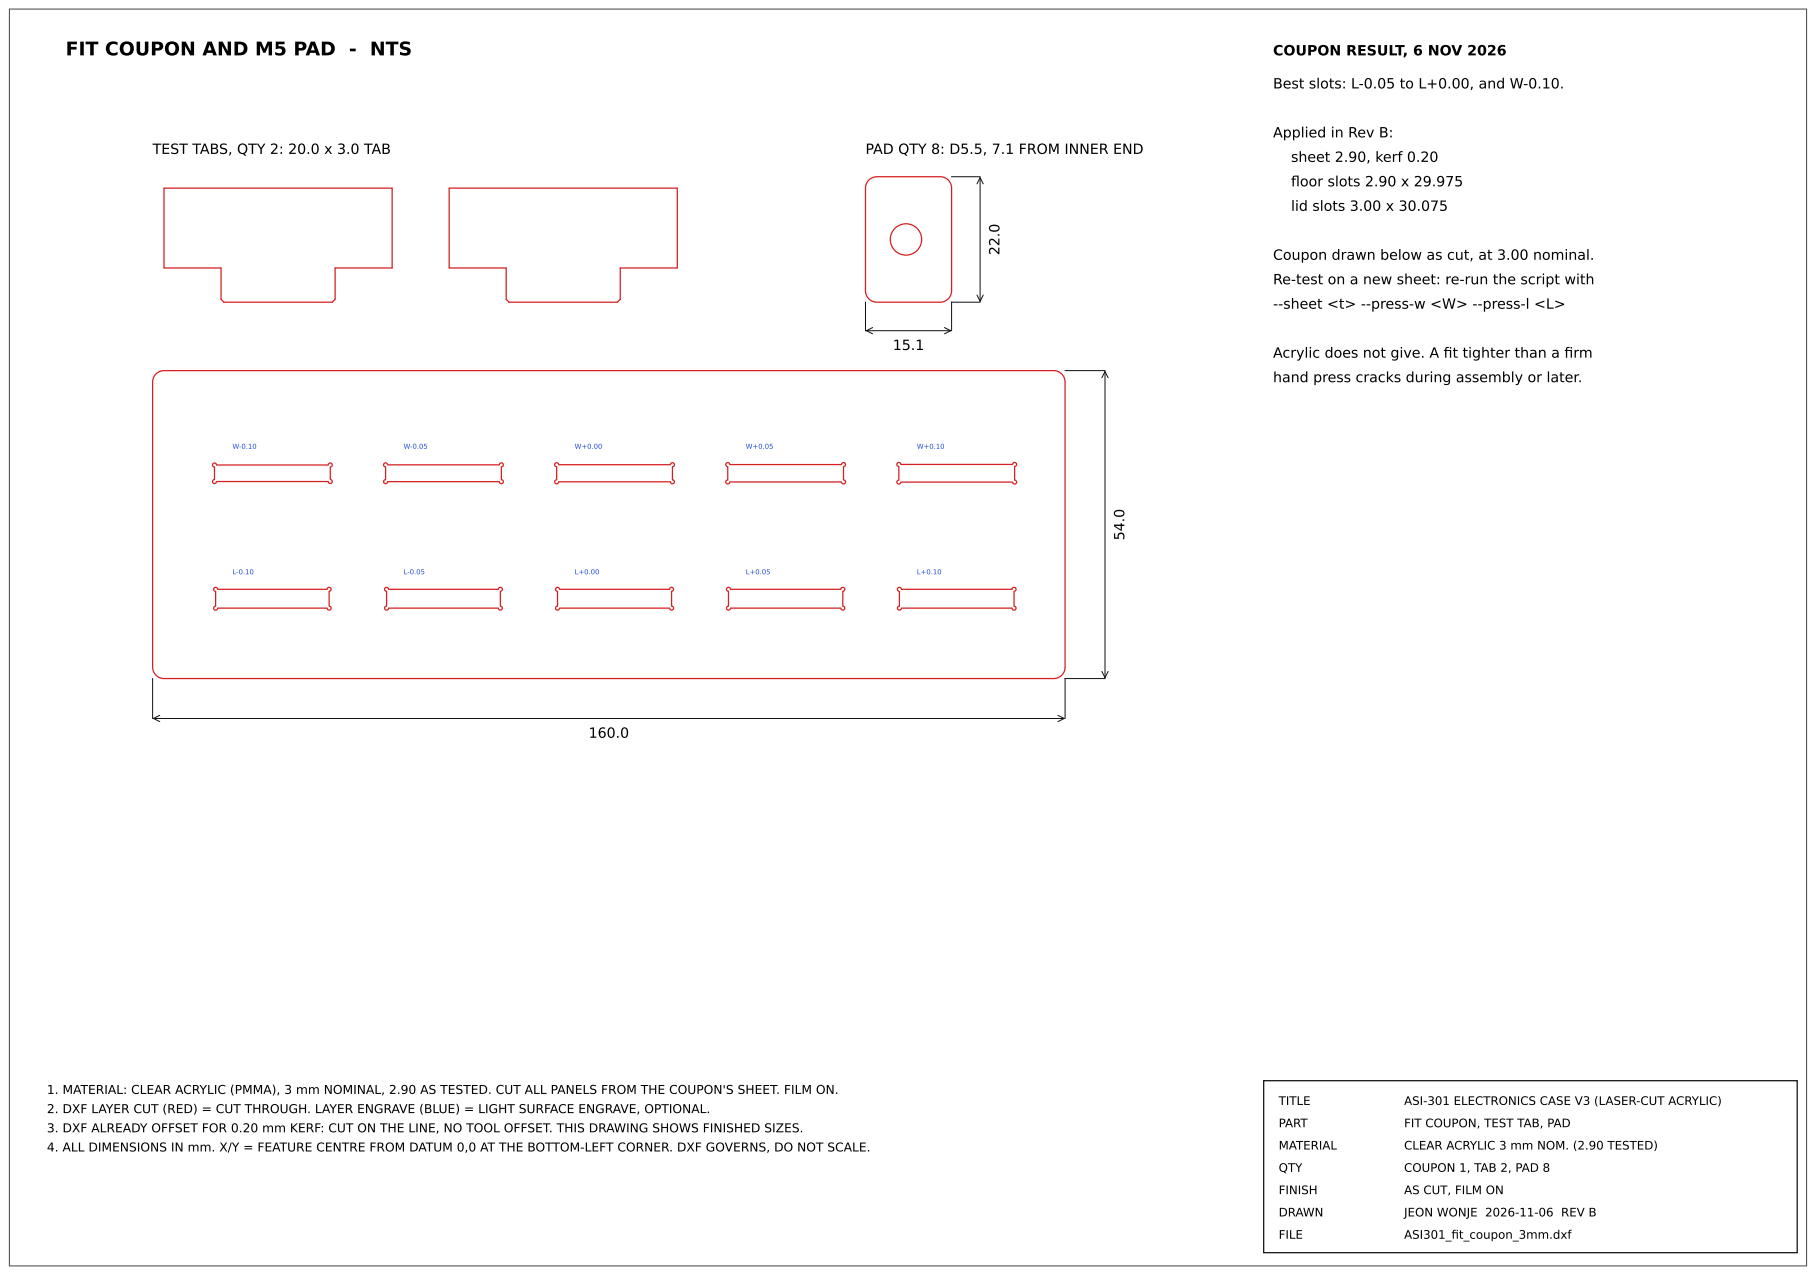
[picture p29: page 8]
lid slots 3.00 x 30.075; TITLE; ASI-301 ELECTRONICS CASE V3 (LASER-CUT ACRYLIC); PART; FIT COUPON, TEST TAB, PAD; MATERIAL; CLEAR ACRYLIC 3 mm NOM. (2.90 TESTED); QTY; COUPON 1, TAB 2, PAD 8; FILE; ASI301_fit_coupon_3mm.dxf

Best slots: L-0.05 to L+0.00, and W-0.10.

Applied in Rev B:
sheet 2.90, kerf 0.20
floor slots 2.90 x 29.975

TEST TABS, QTY 2: 20.0 x 3.0 TAB

PAD QTY 8: D5.5, 7.1 FROM INNER END

Coupon drawn below as cut, at 3.00 nominal.
Re-test on a new sheet: re-run the script with
--sheet <t> --press-w <W> --press-l <L>

Acrylic does not give. A fit tighter than a firm

hand press cracks during assembly or later.

1. MATERIAL: CLEAR ACRYLIC (PMMA), 3 mm NOMINAL, 2.90 AS TESTED. CUT ALL PANELS FROM THE COUPON'S SHEET. FILM ON.
2. DXF LAYER CUT (RED) = CUT THROUGH. LAYER ENGRAVE (BLUE) = LIGHT SURFACE ENGRAVE, OPTIONAL.
3. DXF ALREADY OFFSET FOR 0.20 mm KERF: CUT ON THE LINE, NO TOOL OFFSET. THIS DRAWING SHOWS FINISHED SIZES.
4. ALL DIMENSIONS IN mm. X/Y = FEATURE CENTRE FROM DATUM 0,0 AT THE BOTTOM-LEFT CORNER. DXF GOVERNS, DO NOT SCALE.
