jeonwonje/beachboys/(commit log)

2026-11-06 Speed up rendering and add the timeline from the project chat
    Bake beach noise into a texture, shade only what is visible, redraw shadows
    only when something moves, and precompile materials. Add the Gantt rebuilt
    from the chat record, and correct claims the record doesn't support.
2026-11-06 Add the engineering report and engineering files
    Split the README into a numbered report in docs/, written from the design
    report in ASD-STE100 style. Add wiring diagrams, firmware, case drawings and
    CAD under hardware/, with an index.
    [ASI-301 Electronics Case v3.SLDASM, ASI-301 Electronics Case v3.step, ASI-301_BOM.csv, ASI301_case_acrylic_3mm_nest_revB.dxf, ASI301_fit_coupon_3mm.dxf, Case_v3_Floor.SLDPRT, Case_v3_Lid.SLDPRT, Case_v3_Pads.SLDPRT]
2026-11-06 Use the integrated CAD assembly for the 3D model
    Rebuild the model from the team's STEP assembly, with real spokes, sprockets
    and paddle, and show the electronics case in its chapter. Simplifying before
    computing normals cuts the model to about 100k triangles.
2026-11-07 Condense the documentation and add the CAD assembly
    Merge the report into 6 shorter sections and a one-page README. Add the full
    machine STEP assembly, which replaces the older 3D model in hardware/.
    [ASI-301_integrated_assembly.step]
